k2m5t2/Dummy-Robot/4.Model/Parts to Purchase/motors_related.csv

Name | Type | Quantity
PK513PA-H50S | Motor | 2
2GT-16T-3mm | Pulley | 4
CSF-5-30-1U | Gearbox | 1
