k2m5t2/Dummy-Robot/4.Model/Motor42-Top.step

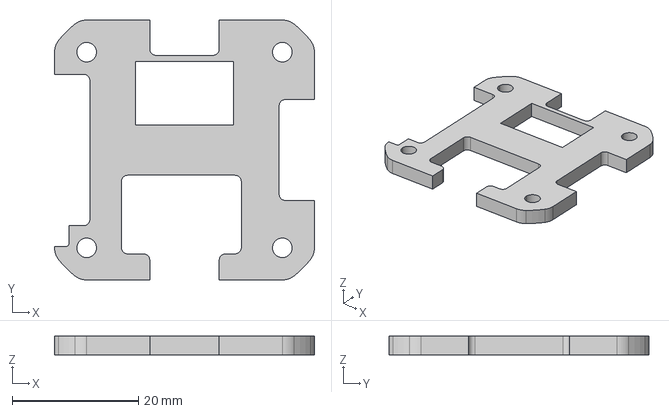
[picture p1: CAD file, 2024-04-16]
4.Model/Motor42-Top.step
41.2 x 41.2 x 3.00 mm
