k2m5t2/Dummy-Robot/4.Model/Parts to 3D Print/Display/Controller Housing.stl

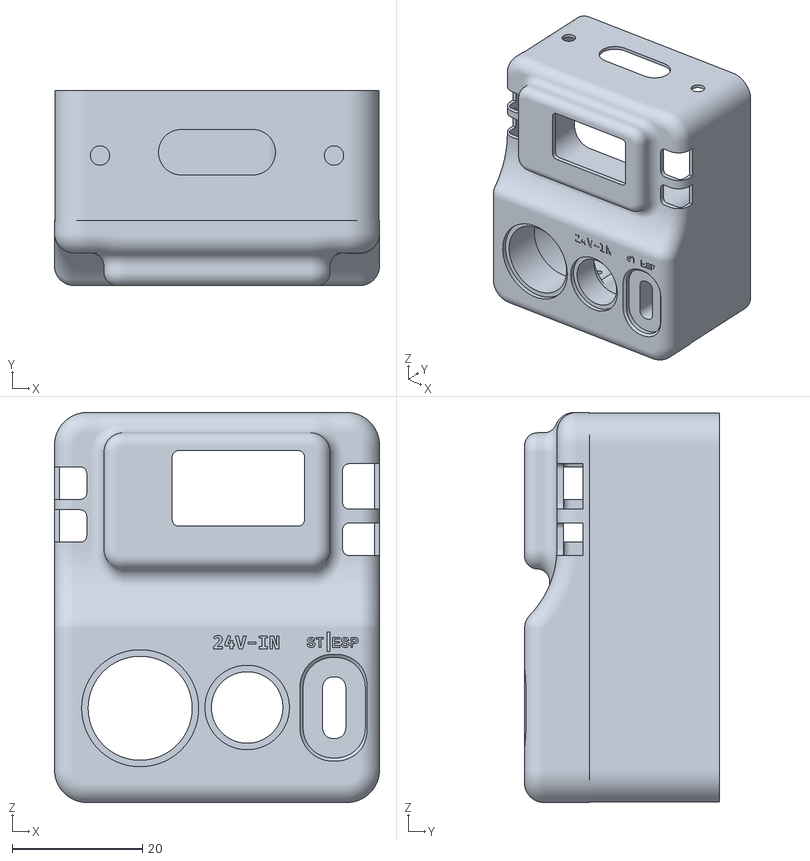
[picture p2: CAD file, 2024-04-16]
4.Model/Parts to 3D Print/Display/Controller Housing.stl
50.0 x 30.0 x 60.0
