k2m5t2/Dummy-Robot/4.Model/Parts to 3D Print/Joint 2 & 3/3D Printed Cover (3).stl

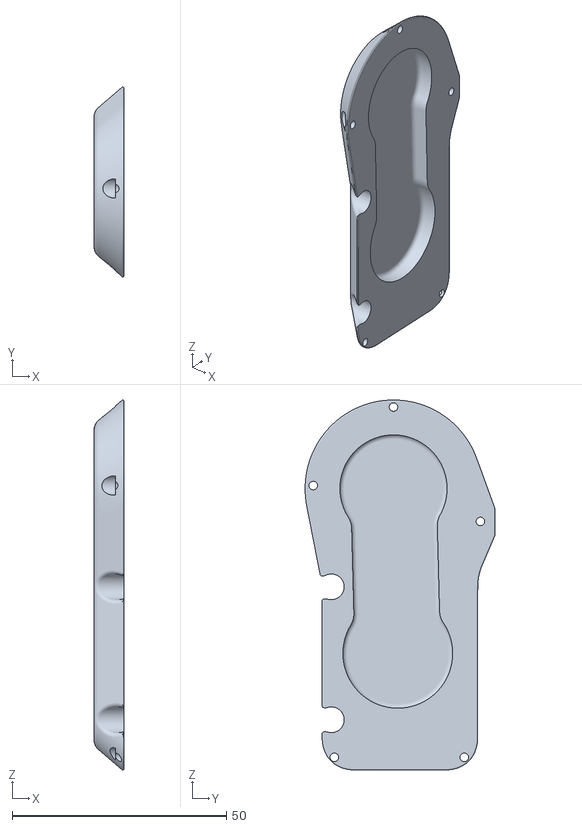
[picture p3: CAD file, 2024-04-16]
4.Model/Parts to 3D Print/Joint 2 & 3/3D Printed Cover (3).stl
7.00 x 44.3 x 86.3
