k2m5t2/Dummy-Robot/4.Model/Parts to 3D Print/Joint 4/3D Printed Cover.stl

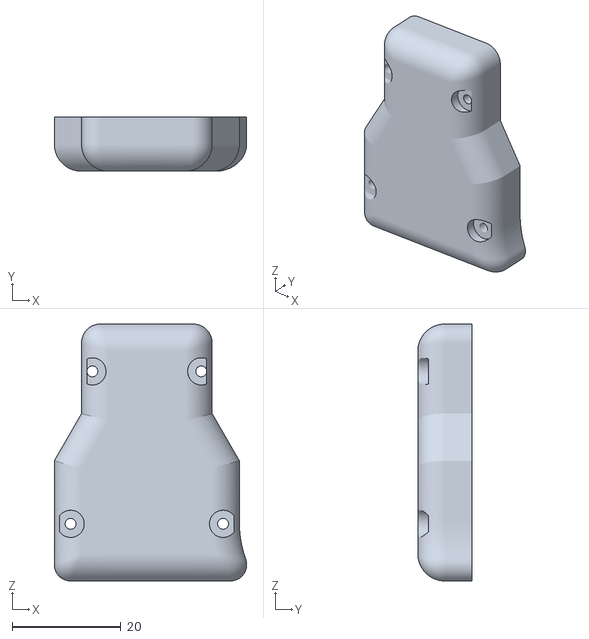
[picture p4: CAD file, 2024-04-16]
4.Model/Parts to 3D Print/Joint 4/3D Printed Cover.stl
35.3 x 10.00 x 47.2
