k2m5t2/Dummy-Robot/4.Model/Parts to 3D Print/Joint 5/3D Printed Cover.stl

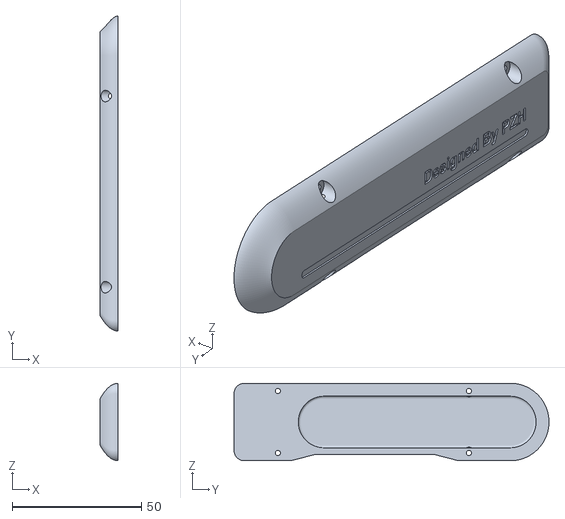
[picture p5: CAD file, 2024-04-16]
4.Model/Parts to 3D Print/Joint 5/3D Printed Cover.stl
7.00 x 122.0 x 30.0
