k2m5t2/Dummy-Robot/4.Model/Parts to 3D Print/Joint 6/3D Printed Cover.stl

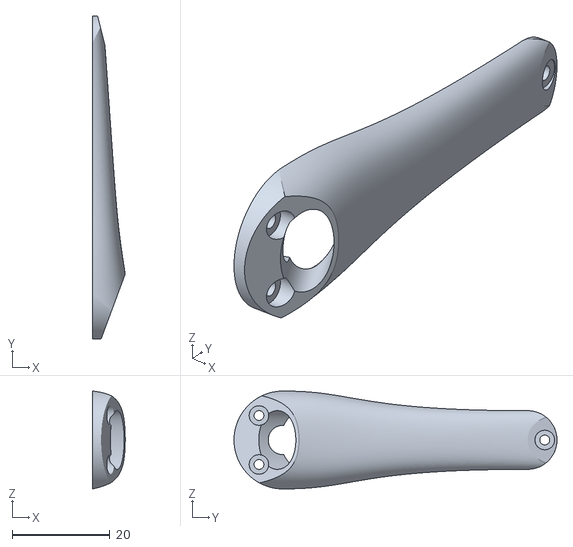
[picture p6: CAD file, 2024-04-16]
4.Model/Parts to 3D Print/Joint 6/3D Printed Cover.stl
6.65 x 66.0 x 20.0
