k2m5t2/Dummy-Robot/4.Model/Parts to Machine (eventually)/Base/Metal Part (4).stl

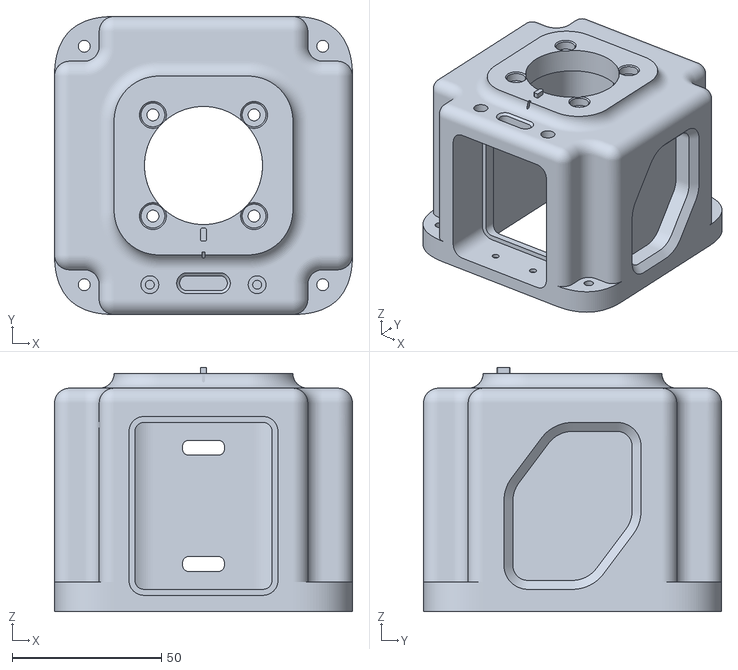
[picture p7: CAD file, 2024-04-16]
4.Model/Parts to Machine (eventually)/Base/Metal Part (4).stl
100.0 x 100.0 x 82.0
