k2m5t2/Dummy-Robot/4.Model/Parts to Machine (eventually)/Display/Acrylic.stl

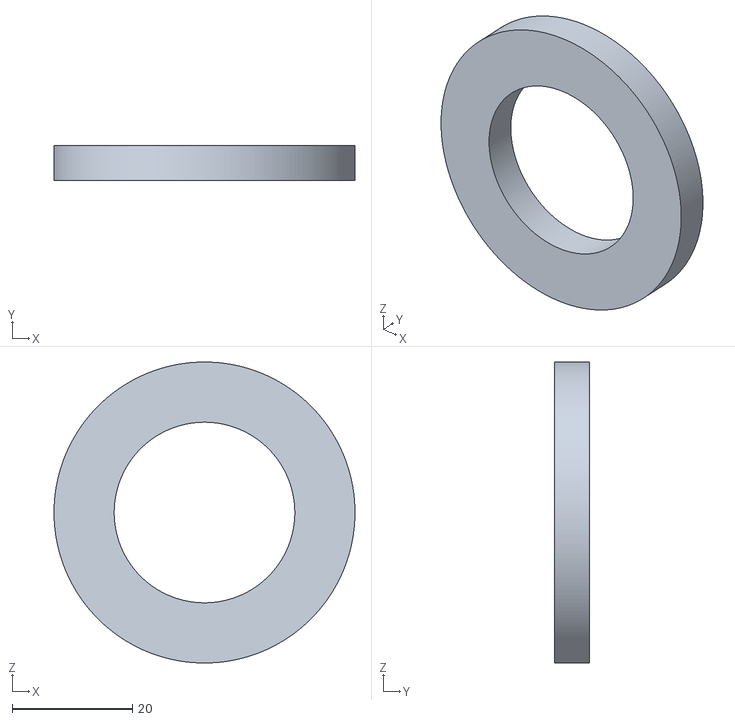
[picture p8: CAD file, 2024-04-16]
4.Model/Parts to Machine (eventually)/Display/Acrylic.stl
50.0 x 5.80 x 50.0
