k2m5t2/Dummy-Robot/4.Model/Parts to Machine (eventually)/Joint 1/Metal Part (3).stl

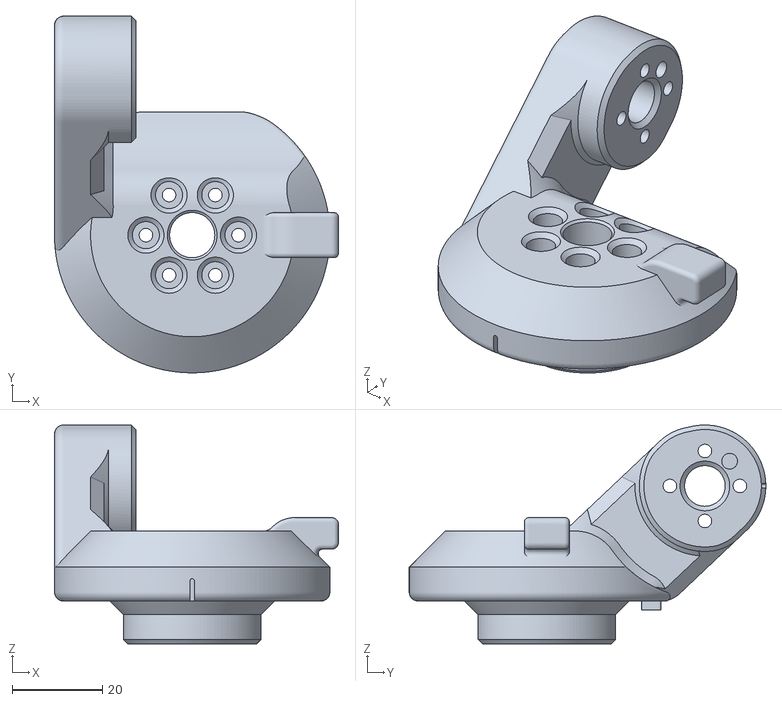
[picture p9: CAD file, 2024-04-16]
4.Model/Parts to Machine (eventually)/Joint 1/Metal Part (3).stl
62.9 x 79.0 x 48.5
