k2m5t2/Dummy-Robot/4.Model/Parts to Machine (eventually)/Joint 2 & 3/Metal Part (2).stl

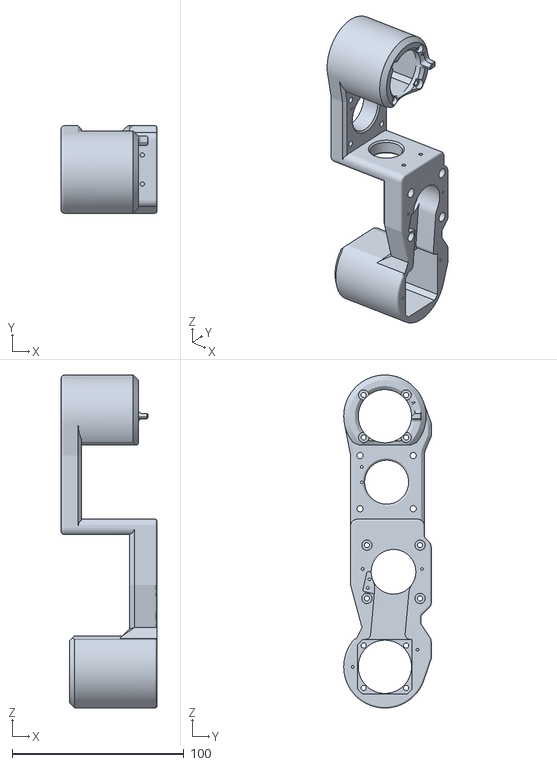
[picture p10: CAD file, 2024-04-16]
4.Model/Parts to Machine (eventually)/Joint 2 & 3/Metal Part (2).stl
55.9 x 51.0 x 194.0
