k2m5t2/Dummy-Robot/4.Model/Parts to Machine (eventually)/Joint 4/Metal Part (1).stl

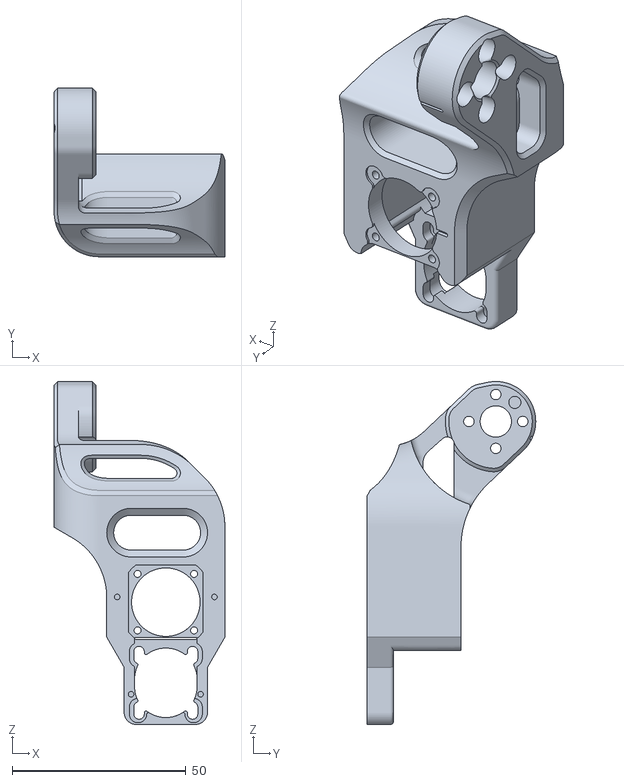
[picture p11: CAD file, 2024-04-16]
4.Model/Parts to Machine (eventually)/Joint 4/Metal Part (1).stl
49.2 x 48.5 x 98.7
