k2m5t2/Dummy-Robot/4.Model/Parts to Machine (eventually)/Joint 5/Metal Part (small).stl

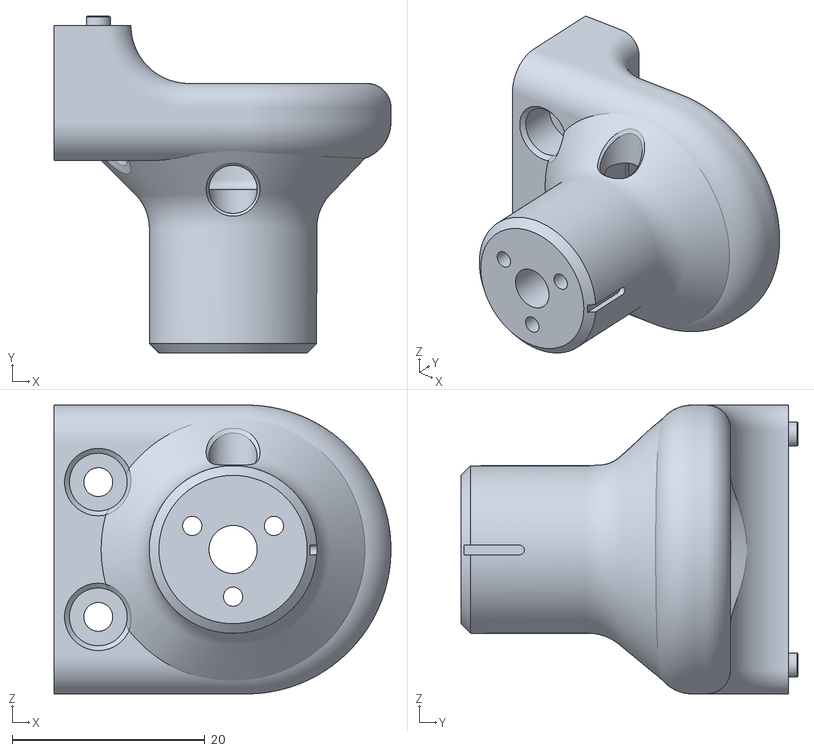
[picture p12: CAD file, 2024-04-16]
4.Model/Parts to Machine (eventually)/Joint 5/Metal Part (small).stl
35.0 x 35.0 x 30.0
