k2m5t2/Dummy-Robot/4.Model/Parts to Machine (eventually)/Joint 6/Metal Part.stl

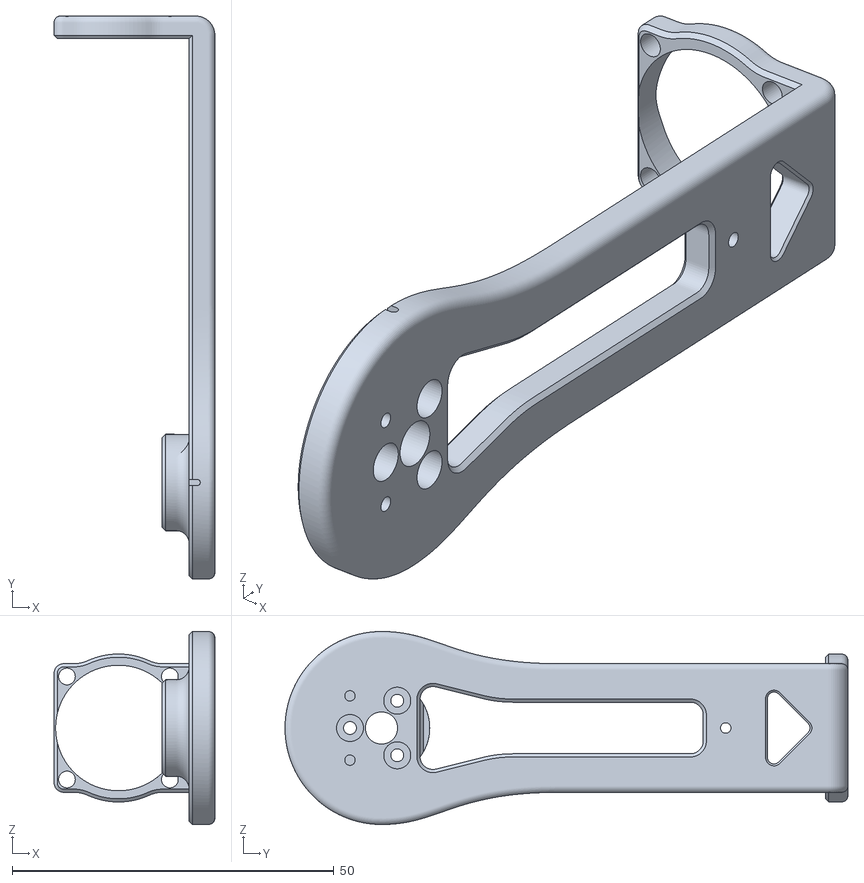
[picture p13: CAD file, 2024-04-16]
4.Model/Parts to Machine (eventually)/Joint 6/Metal Part.stl
25.0 x 87.5 x 30.0
