k2m5t2/Dummy-Robot/4.Model/Parts to Machine/Joint 6/Metal Part.step

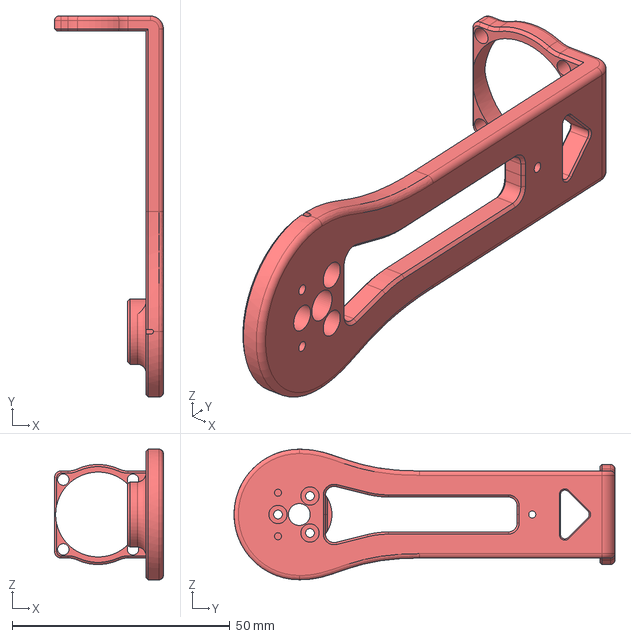
[picture p14: CAD file, 2024-04-16]
4.Model/Parts to Machine/Joint 6/Metal Part.step
25.0 x 87.5 x 30.0 mm
