k2m5t2/Dummy-Robot/4.Model/Parts to 3D Print/Display/Controller Inner Shell.stl

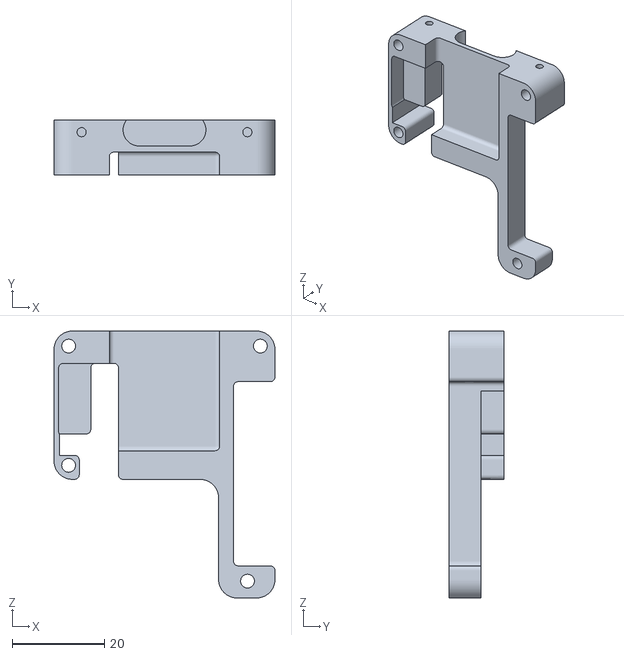
[picture p16: CAD file, 2024-04-16]
4.Model/Parts to 3D Print/Display/Controller Inner Shell.stl
48.0 x 12.0 x 58.0
