k2m5t2/Dummy-Robot/4.Model/Parts to 3D Print/Joint 2 & 3/3D Printed Cover (4).stl

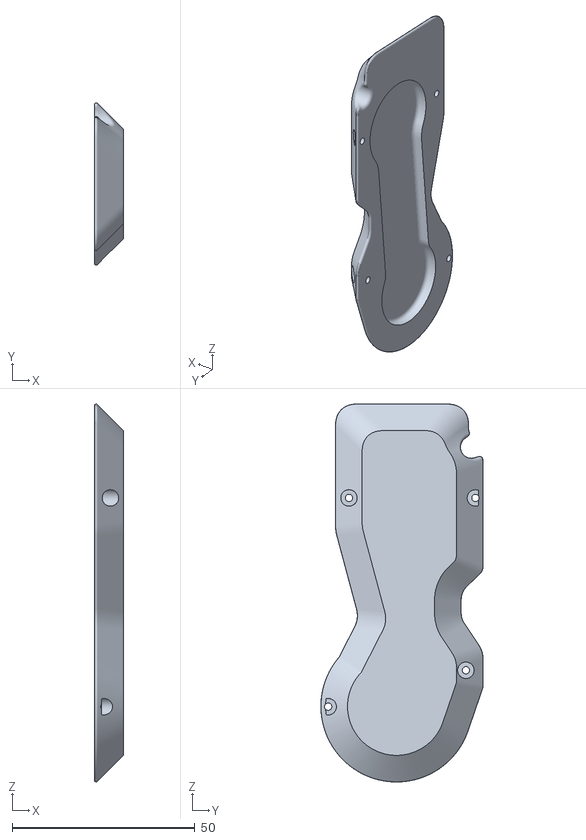
[picture p17: CAD file, 2024-04-16]
4.Model/Parts to 3D Print/Joint 2 & 3/3D Printed Cover (4).stl
8.00 x 44.4 x 103.4
