k2m5t2/Dummy-Robot/4.Model/Parts to Machine (eventually)/Joint 5/Metal Part (large).stl

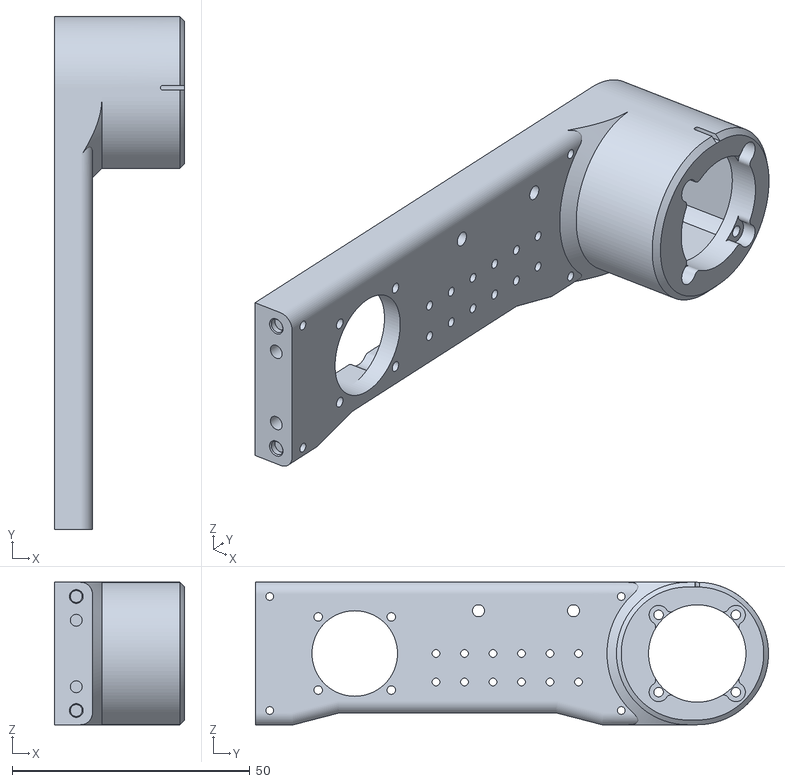
[picture p18: CAD file, 2024-04-16]
4.Model/Parts to Machine (eventually)/Joint 5/Metal Part (large).stl
27.4 x 108.0 x 30.0
