k2m5t2/Dummy-Robot/(list of files, cad)

Other CAD files:
4.Model/Parts to Machine/Base/Metal Part (4).step
4.Model/Parts to Machine/Display/Acrylic.step
4.Model/Parts to Machine/Joint 1/Metal Part.step
4.Model/Parts to Machine/Joint 2 & 3/Metal Part (2).step
4.Model/Parts to Machine/Joint 4/Metal Part (1).step
4.Model/Parts to Machine/Joint 5/Metal Part (small).step
4.Model/Parts to Machine/Joint 5/Metal Part (large).step
